ForrestErickson/MissingPulseDetector/(list of files, drawings)

Other design files:
RPIB_GARAGE_SSRELAY_SENSE_OPEN&CLOSE_RANGE_20171220.pcb
