ForrestErickson/MissingPulseDetector/(commit log)

2020-12-19 Add ISR for button press and set for time out of 3 seconds. This works.
2020-12-19 Add serial reporting and splash message. Report reason for missed pulse.
    [MissingPulseDetector.ino]
2021-01-25 Modify to detect real pulses from real garage door safety sensor and tested 20210125.
2021-01-25 Add schematic and PCB for RPi interface and images.
    [RPIB_GARAGE_SSRELAY_SENSE_OPEN&CLOSE_RANGE_20171220.pcb, RPIB_GARAGE_SSRELAY_SENSE_OPEN&CLOSE_RANGE_20210125.sch]
2021-01-26 Add wiring photograph.
2021-01-26 Update README.md
    Images of schematic and PCB and wiring to ESP32 Dev Kit V4.
2021-01-26 Add oscilloscope wavforms of optical coupler interface.
